A-Kester/a-kester.github.io/src/images/IMG_5209.jpeg

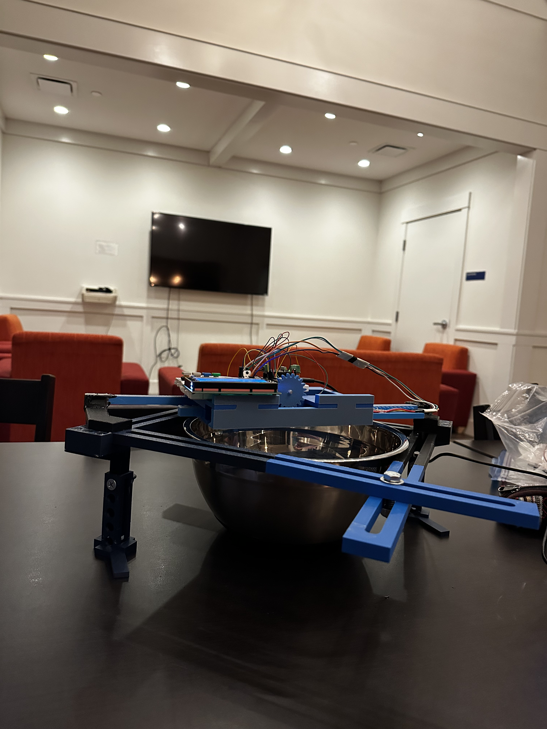
src/images/IMG_5209.jpeg
