A-Kester/a-kester.github.io/arduino_src/Doughbot/Motor.h

#include <Adafruit_MotorShield.h>

#define MOTOR_STEPS 200
#define DEFUALT_RPM 1

Adafruit_MotorShield AFMS = Adafruit_MotorShield();
// Or, create it with a different I2C address (say for stacking)
// Adafruit_MotorShield AFMS = Adafruit_MotorShield(0x61);

// Connect a stepper motor with 200 steps per revolution (1.8 degree)
// to motor port #2 (M3 and M4)
Adafruit_StepperMotor *myMotor = AFMS.getStepper(200, 2);
Adafruit_StepperMotor* motor;
