A-Kester/a-kester.github.io/(commit log)

2025-12-07 Added Arduino Files
2025-12-08 Clean up and Integration
    Created header files for:
    1) Button controls,
    2) Display functions
    3) Motor functions
    4) TOF sensor
    5) Temp and Humidity sensor
    6) General helpers
    State machine still needs serious cleaning.
2025-12-10 Adding timer
