A-Kester/a-kester.github.io/src/images/Dbot_zero.jpeg

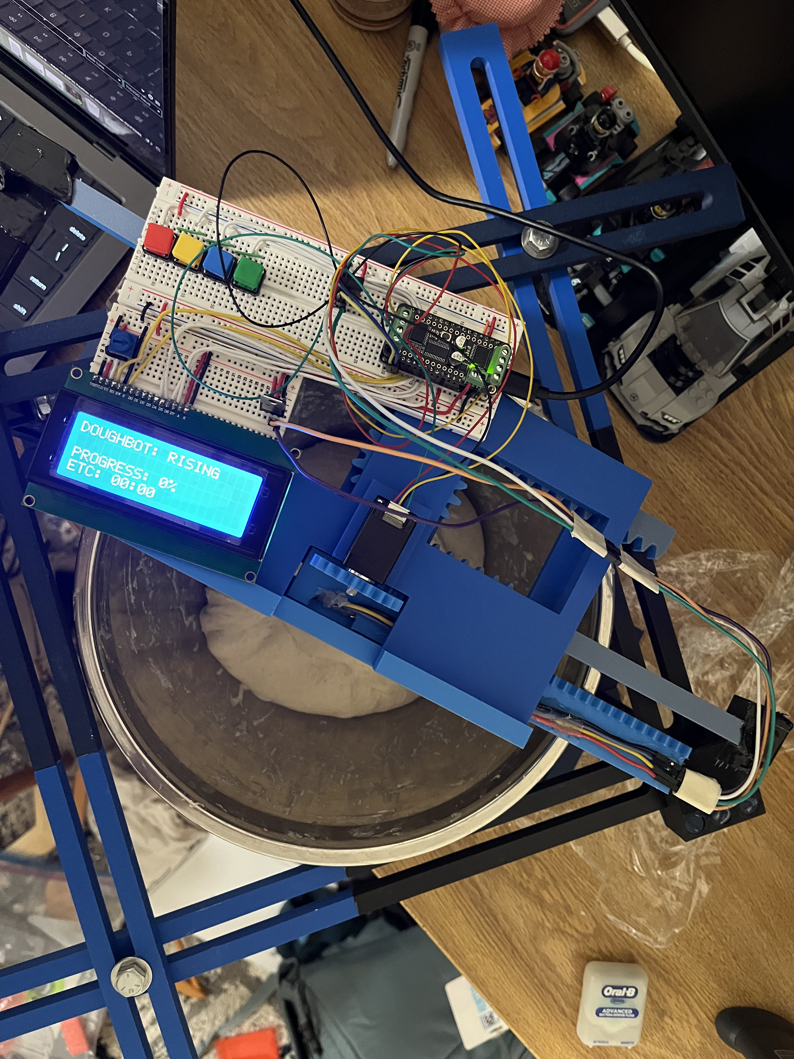
[picture p8: src/images/Dbot_zero.jpeg]
src/images/Dbot_zero.jpeg
