A-Kester/a-kester.github.io/src/images/Dbot_mid.jpeg

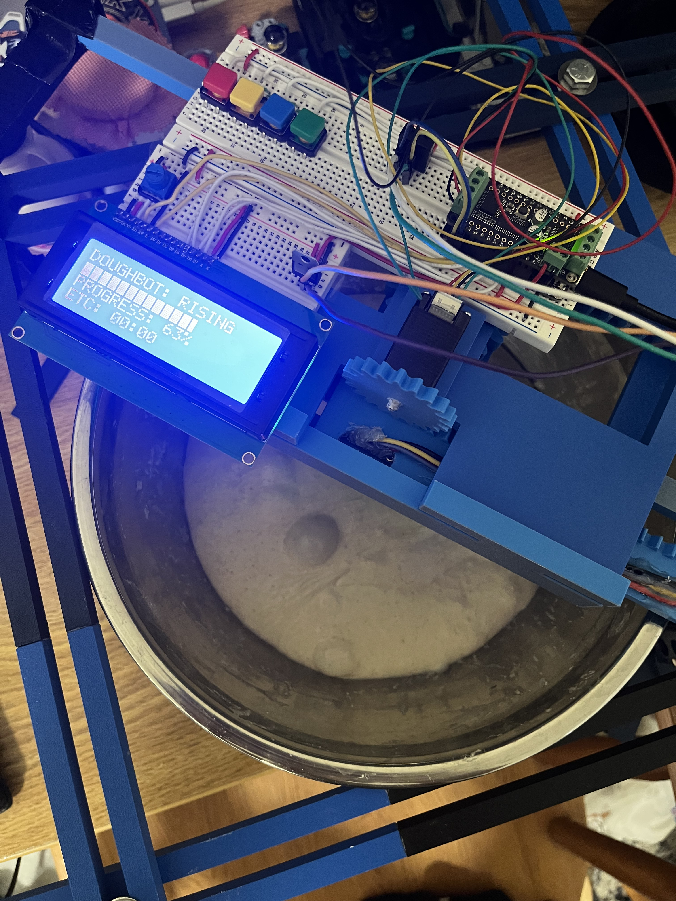
[picture p9: src/images/Dbot_mid.jpeg]
src/images/Dbot_mid.jpeg
